Skyler-Cornell/E90/Hardware/E90 Kicad Files/E90.sch

## KiCad design Hardware/E90 Kicad Files/E90.sch (2021-05-10)

Schematic: E90.sch

Parts:
ADC1_IN1, ADC1_IN2, ADC1_IN3: R_POT_US; Potentiometer_Bourns_PTV09A-1_Single_Vertical
C1, C2: 10uF; C_0805_2012Metric; LCSC Part # C15850
C3, C8, C13, C16, C17, C18, C19, C20, C21, C22, C23, C33: 100nf; C_0402_1005Metric; LCSC Part # C1525
C4, C24: 4.7uF; C_0603_1608Metric; LCSC Part # C19666
C5, C25, C30: 100nF; C_0402_1005Metric; LCSC Part # C1525
C6, C9, C10, C11, C15, C26, C35: 10uF; C_0603_1608Metric; LCSC Part # C19702
C7: 3.3uF; C_0603_1608Metric; LCSC Part # C51412
C12: 2.7nF; C_0603_1608Metric; LCSC Part # C1609
C14: 10nF; C_0402_1005Metric; LCSC Part # C15195
C27, C28: 2.2uF; C_0603_1608Metric; LCSC Part # C23630
C29, C32, C34: 1uF; C_0603_1608Metric; LCSC Part # C15849
C31: 10uF; C_0805_2012Metric; LCSC C15850
C36: 180pF; C_0603_1608Metric; LCSC Part # C18437
C38, C39: 12pF; C_0402_1005Metric; LCSC Part # C1547
D1, D3: B5819W; D_SOD-123; LCSC Part # C8598
D2: LED_Green; LED_0603_1608Metric; LCSC Part # C72043
D4, D5, D6: LED_RGBA; 19-237-R6GHBHC-A01-2T; LCSC C60105
FB1, FB3: 100 @100 MHz; L_0805_2012Metric; LCSC Part # C1015
FB2, FB4: 600 @100 MHz; L_0805_2012Metric; LCSC Part # C1017
H1, H2, H3, H4: MountingHole_Pad; MountingHole_4.3mm_M4_Pad_Via
HSE1: 16MHz; Crystal_SMD_3225-4Pin_3.2x2.5mm; LCSC Part # C13738
InputGain1: 100k; Potentiometer_Piher_PT-10-V10_Vertical
J1, J4, J6: Conn_01x03; PinHeader_1x03_P2.54mm_Vertical
J2: SWD Connector Conn_02x03; PinHeader_2x03_P2.54mm_Vertical
J3: Power Test Point Conn_01x02; PinHeader_1x02_P2.54mm_Vertical
J5: Conn_01x02; PinHeader_1x02_P2.54mm_Vertical
J7: USB_B_Mini; USB_Mini-B_Lumberg_2486_01_Horizontal
J8: Barrel_Jack_Switch; BarrelJack_Horizontal
J9, J10: SJ-63073E; CUI_SJ-63073E; PARTREV 1.0
R1: 2k2; R_0603_1608Metric; LCSC Part # C4190
R2, R7: 1; R_0805_2012Metric; LCSC Part # C25271
R3, R5, R9, R10, R12: 10k; R_0603_1608Metric; LCSC Part # C25804
R4: 470; R_0603_1608Metric; LCSC Part # C23179
R6: 10K; R_0603_1608Metric; LCSC Part # C25804
R8: 47; R_0603_1608Metric; LCSC Part # C23182
R11, R13: 5.1K; R_0603_1608Metric; LCSC Part # C23186
R14: 100; R_0603_1608Metric; LCSC Part # C22775
R15, R16, R17, R18, R19, R20, R21, R31, R32, R33, R34: 10k; R_0603_1608Metric; LCSC Part # C23186
R22, R23, R24, R25, R26, R27, R28, R29, R30: 1k; R_0603_1608Metric; LCSC Part # C23182
U1: AMS1117-3.3; SOT-223-3_TabPin2; LCSC Part # C6186
U2: CS4344_CZZ; SOP50P490X110-10N
U3: TLV2774; DIP-14_W7.62mm_LongPads
U4: CS5343_CZZ; SOP50P490X110-10N
U5: STM32F407VGT60; LQFP-100_14x14mm_P0.5mm; LCSC Part # C12345
U6: USBLC6-2SC6; SOT-23-6; LCSC C7519
Volume1: 10k; Potentiometer_Bourns_PTV09A-1_Single_Vertical

Notes on the sheet:
Power and Programming Connectors
Crystal Circuitry
D/A
Analog Power Supply Filtering
Crystal Load Capacitors
VDD Decoupling (one 100nF per VDD, one for VBAT, one 10uF for the package)
assumes CW 2->3
Attenuator Pot
Boot mode selection
Output Voltage Follower
Input Gain Stage
Parameter Pots
Quad OP Amp Circuit IN/OUT
RGB LEDs
Input Voltage Regulation
A/D
GPIO
I2C
Center Negative Plug
U3C Unused
U3A Unused
