Skyler-Cornell/E90/Firmware/Audio_Processor_E90/Core/Src/main.c

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

/* Includes ------------------------------------------------------------------*/
#include "main.h"

/* USER CODE BEGIN Includes */

#include "audio_process.h"

/* USER CODE END Includes */

I2S_HandleTypeDef hi2s2;
DMA_HandleTypeDef hdma_i2s2_ext_rx;
DMA_HandleTypeDef hdma_spi2_tx;

/* USER CODE BEGIN PV */

// receive and transmit buffers (twice the size of a block see ping pong buffer architecture)
// Every Ts one left and one right sample is xfered so 4 uint16_t 's are required as 1/2 of the buffer
uint16_t rx_buf[8];
uint16_t tx_buf[8];
int left_in, right_in, left_out, right_out = 0;

/* USER CODE END PV */

void SystemClock_Config(void);
static void MX_GPIO_Init(void);
static void MX_DMA_Init(void);
static void MX_I2S2_Init(void);
/**
  * @brief  The application entry point.
  * @retval int
  */
int main(void)
{
  /* MCU Configuration--------------------------------------------------------*/

  /* Reset of all peripherals, Initializes the Flash interface and the Systick. */
  HAL_Init();

  /* Configure the system clock */
  SystemClock_Config();

  /* Initialize all configured peripherals */
  MX_GPIO_Init();
  MX_DMA_Init();
  MX_I2S2_Init();
  /* USER CODE BEGIN 2 */
  HAL_GPIO_WritePin(GPIOD, GPIO_PIN_14, GPIO_PIN_SET);
  process_init();
  HAL_I2SEx_TransmitReceive_DMA(&hi2s2, tx_buf, rx_buf, 4);

  /* USER CODE END 2 */

  /* Infinite loop */
  /* USER CODE BEGIN WHILE */
  while (1)
  {
    /* USER CODE END WHILE */

    /* USER CODE BEGIN 3 */
  }
  /* USER CODE END 3 */
}

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
/* USER CODE BEGIN 4 */

//I2S RX line DMA transfer half complete callback
void HAL_I2SEx_TxRxHalfCpltCallback(I2S_HandleTypeDef *hi2s)
{
  //shift right by 8 to right justify the 24 bit sample that had been xfered on a 32 bit frame
  left_in  = (((int)rx_buf[0]<<16)|rx_buf[1])>>8;
  right_in = (((int)rx_buf[2]<<16)|rx_buf[3])>>8;

  // does the audio processing
  process(&left_in, &right_in, &left_out, &right_out);

  tx_buf[0] = (left_out>>8) & 0xFFFF;
  tx_buf[1] = left_out & 0xFFFF;
  tx_buf[2] = (right_out>>8) & 0xFFFF;
  tx_buf[3] = right_out & 0xFFFF;

}

//I2S RX line DMA transfer complete callback
void HAL_I2SEx_TxRxCpltCallback(I2S_HandleTypeDef *hi2s)
{
  //shift right by 8 to right justify the 24 bit sample that had been xfered on a 32 bit frame
  left_in  = (((int)rx_buf[4]<<16)|rx_buf[5])>>8;
  right_in = (((int)rx_buf[6]<<16)|rx_buf[7])>>8;

  // does the audio processing
  process(&left_in, &right_in, &left_out, &right_out);

  tx_buf[4] = (left_out>>8) & 0xFFFF;
  tx_buf[5] = left_out & 0xFFFF;
  tx_buf[6] = (right_out>>8) & 0xFFFF;
  tx_buf[7] = right_out & 0xFFFF;

}

/* USER CODE END 4 */
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
