Skyler-Cornell/E90/Firmware/Audio_Processor_E90/Audio_Processor_E90.ioc

Mcu.UserName=STM32F407VGTx
PB10.Signal=I2S2_CK
PB12.Signal=I2S2_WS
PC2.Signal=I2S2_ext_SD
PC3.Signal=I2S2_SD
PC6.Signal=I2S2_MCK
PH0-OSC_IN.Signal=RCC_OSC_IN
PH1-OSC_OUT.Signal=RCC_OSC_OUT
