Skyler-Cornell/E90/Firmware/Audio_Processor_E90/Core/Inc/audio_process.h

/*
 * audio_process.h
 *
 *  Created on: Jan 22, 2021
 *      Author: skylercornell
 */

#ifndef INC_AUDIO_PROCESS_H_
#define INC_AUDIO_PROCESS_H_

#endif /* INC_AUDIO_PROCESS_H_ */

#include "main.h"

void process_init();
void process(int *left_in, int *right_in, int *left_out, int *right_out);
